berred16/BT9803-Modul/IMG_0519.JPG

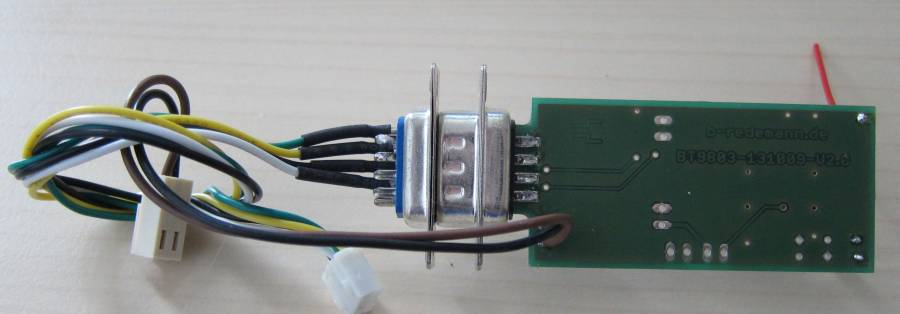
IMG_0519.JPG
