berred16/BT9803-Modul/IMG_0517.JPG

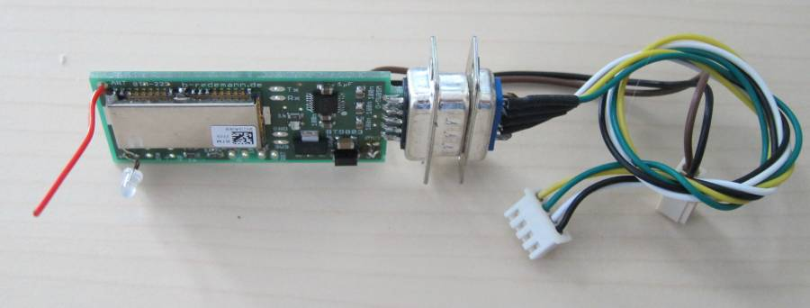
IMG_0517.JPG
