berred16/BT9803-Modul/BT9803-Bestückung.png

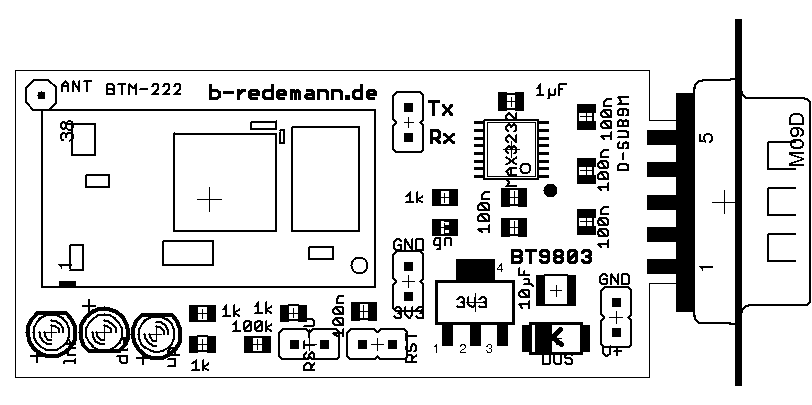
BT9803-Bestückung.png
