berred16/BT9803-Modul/BT9803-Stromlauf.png

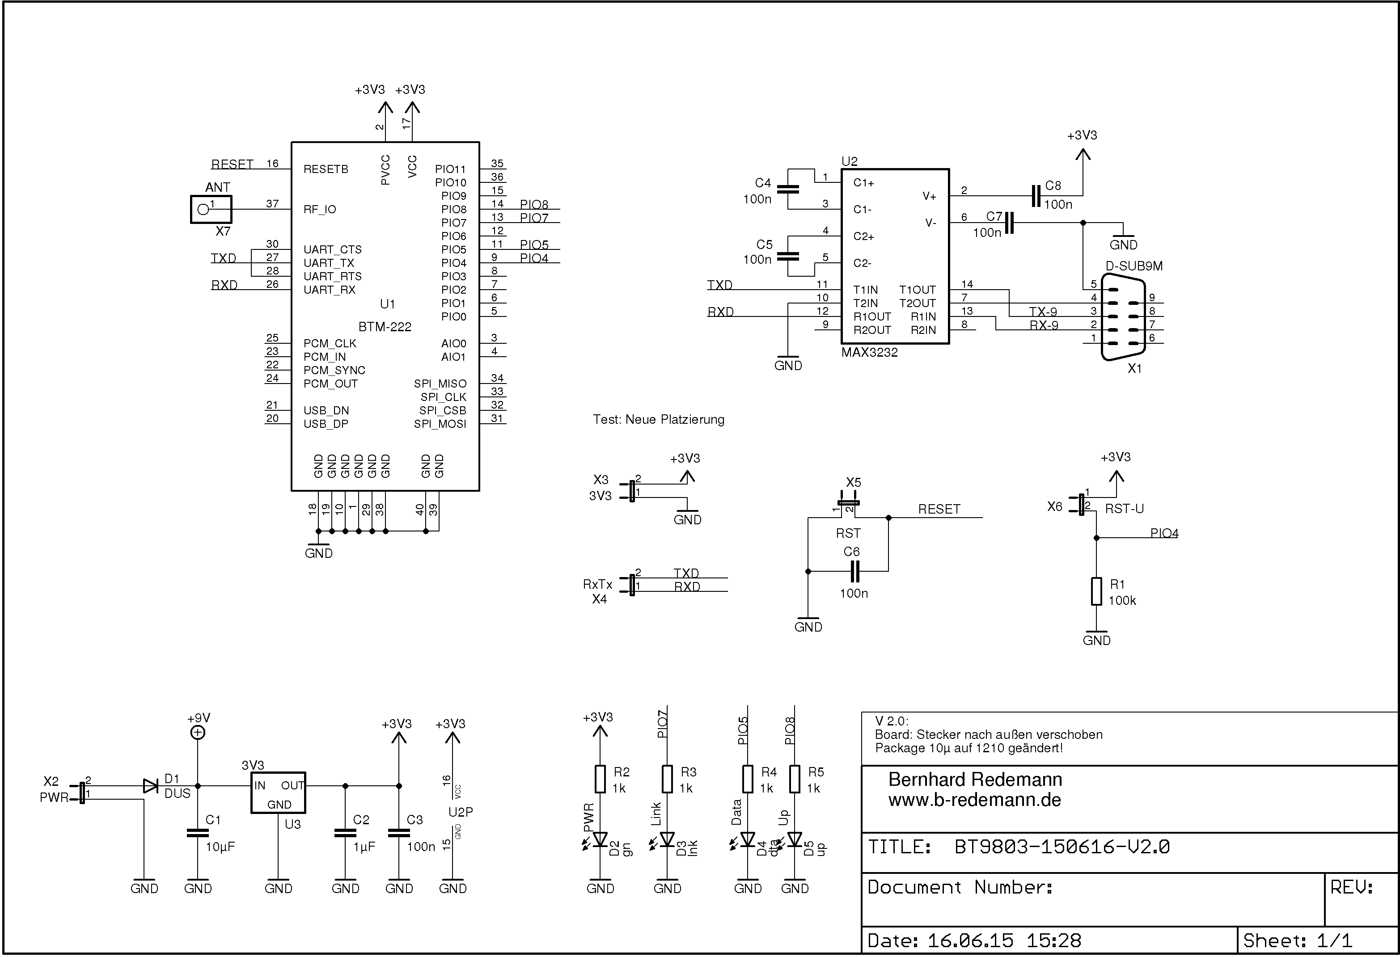
BT9803-Stromlauf.png
