berred16/BT9803-Modul/IMG_0501.JPG

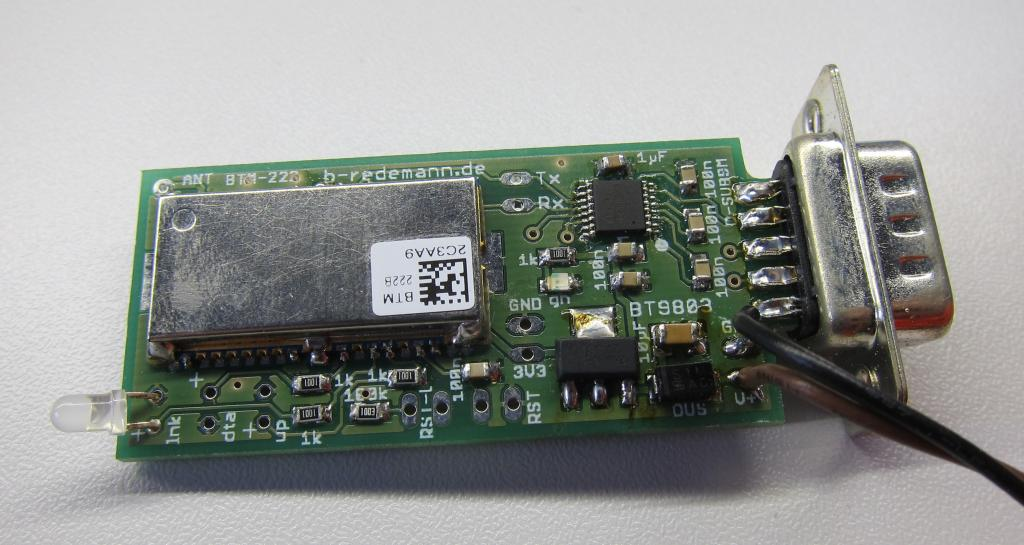
IMG_0501.JPG
