berred16/BT9803-Modul/IMG_0518.JPG

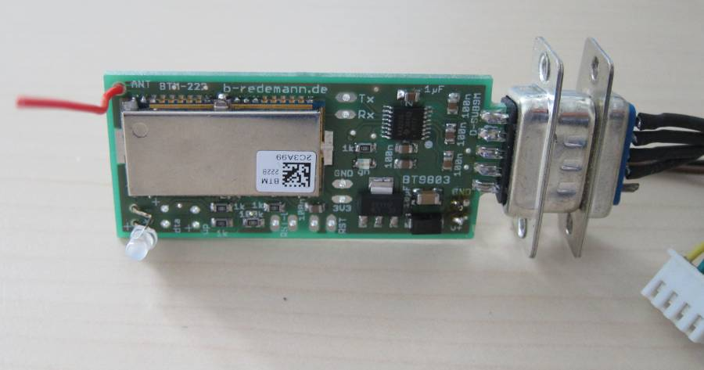
IMG_0518.JPG
