berred16/BT9803-Modul/IMG_0523.JPG

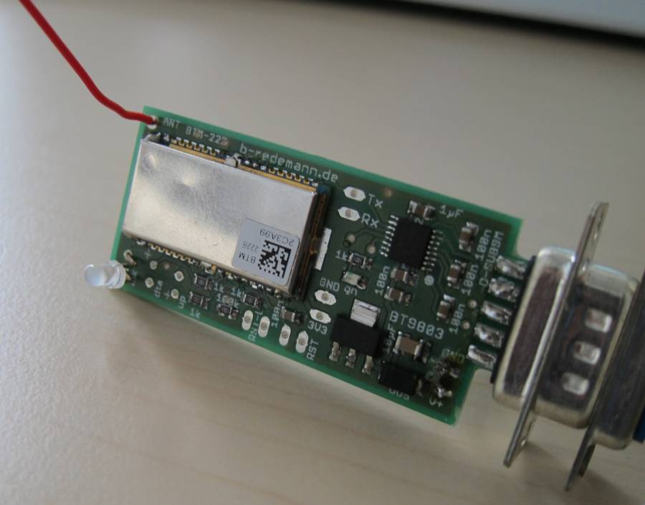
IMG_0523.JPG
