berred16/BT9803-Modul/BT9803-150616-V2.0.brd

## EAGLE design BT9803-150616-V2.0.brd (2016-10-22)

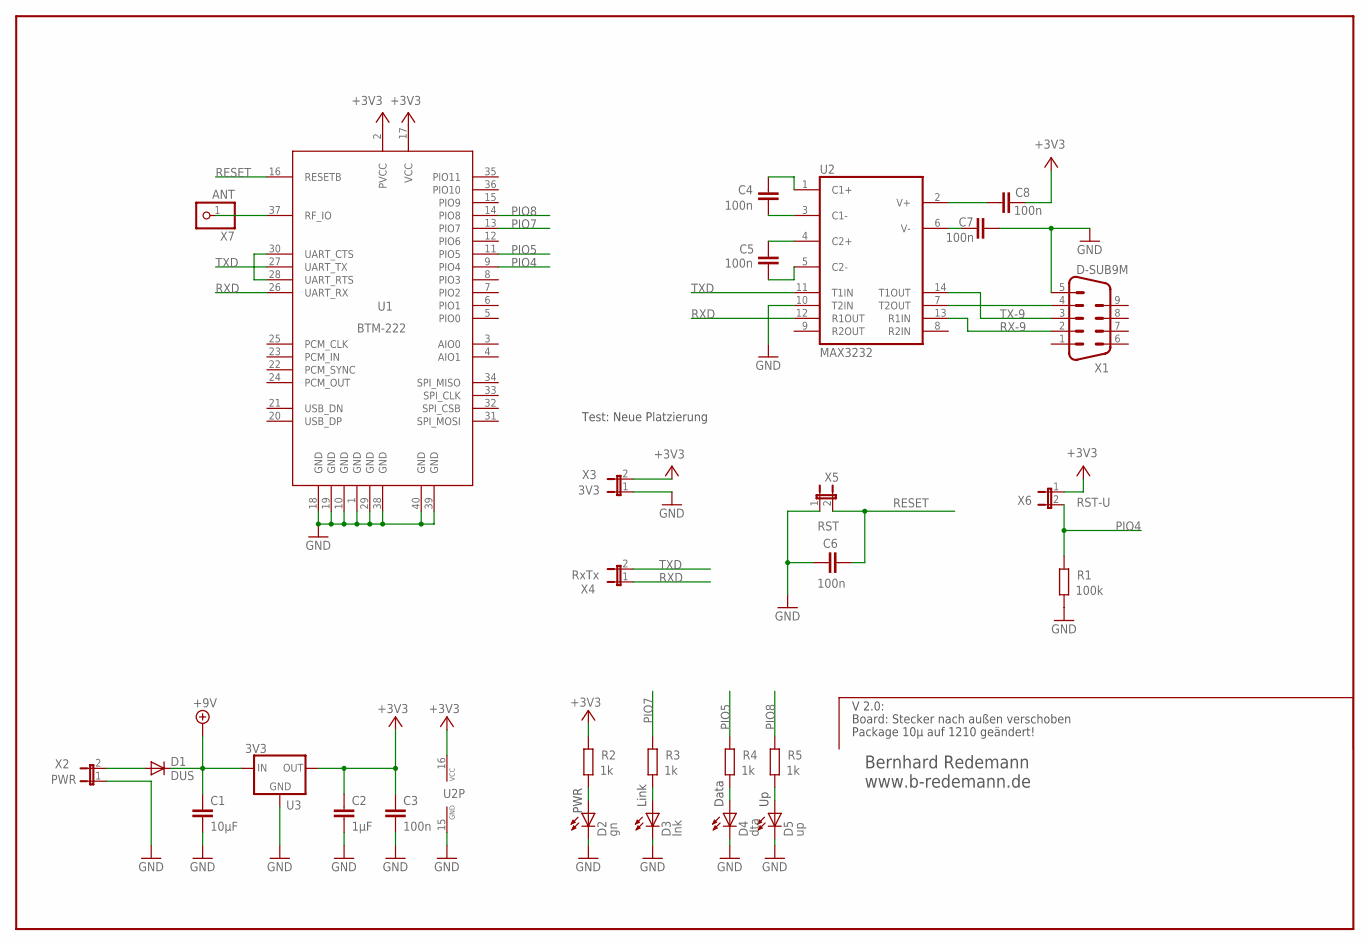
[picture p15: schematic BT9803-150616-V2.0.sch]

Parts:
C1: 10µF; C1210
C2: 1µF; C0805
C3, C4, C5, C6, C7, C8: 100n; C0805
D1: DUS; DO-214AC
D2: gn; CHIP-LED0805
D3: lnk; LED3MM
D4: dta; LED3MM
D5: up; LED3MM
R1: 100k; R0805
R2, R3, R4, R5: 1k; R0805
U1: BTM-222; 38-PIN15
U2: MAX3232; TSSOP16
U3: 3V3; SOT223
X1: D-SUB9M; M09D
X2: PWR; JP1
X3: 3V3; JP1
X4: RxTx; JP1
X5: RST; JP1
X6: RST-U; JP1
X7: ANT; 1X01

Connections:
+3V3: C2.1, C3.1, C8.1, R2.1, U1.2 (PVCC), U1.17 (VCC), U2.16 (VCC), U3.2 (OUT), X3.2, X6.1
+9V: C1.1, D1.C, U3.3 (IN)
DATA: D4.A, R4.2
GND: C1.2, C2.2, C3.2, C6.1, C7.1, D2.C, D3.K (C), D4.K (C), D5.K (C), R1.2, U1.1 (GND), U1.10 (GND), U1.18 (GND), U1.19 (GND), U1.29 (GND), U1.38 (GND), U1.39 (GND), U1.40 (GND), U2.10 (T2IN), U2.15 (GND), U3.1 (GND), X1.5, X2.1, X3.1, X5.1
LINK: D3.A, R3.2
unnamed: U2.7 (T2OUT), X1.4
unnamed: U1.28 (UART_RTS), U1.30 (UART_CTS)
unnamed: D1.A, X2.2
unnamed: C4.1, U2.3 (C1-)
unnamed: C5.2, U2.4 (C2+)
unnamed: C4.2, U2.1 (C1+)
unnamed: C5.1, U2.5 (C2-)
unnamed: C7.2, U2.6 (V-)
unnamed: C8.2, U2.2 (V+)
PIO4: R1.1, U1.9 (PIO4), X6.2
PIO5: R4.1, U1.11 (PIO5)
PIO7: R3.1, U1.13 (PIO7)
PIO8: R5.1, U1.14 (PIO8)
PWR: D2.A, R2.2
RESET: C6.2, U1.16 (RESETB), X5.2
RF-222: U1.37 (RF_IO), X7.1
RX-9: U2.13 (R1IN), X1.2
RXD: U1.26 (UART_RX), U2.12 (R1OUT), X4.1
TX-9: U2.14 (T1OUT), X1.3
TXD: U1.27 (UART_TX), U2.11 (T1IN), X4.2
UP: D5.A, R5.2

Notes on the sheet:
Bernhard Redemann www.b-redemann.de
Link
PWR
Data
Package 10µ auf 1210 geändert!
Board: Stecker nach außen verschoben
V 2.0:
Test: Neue Platzierung

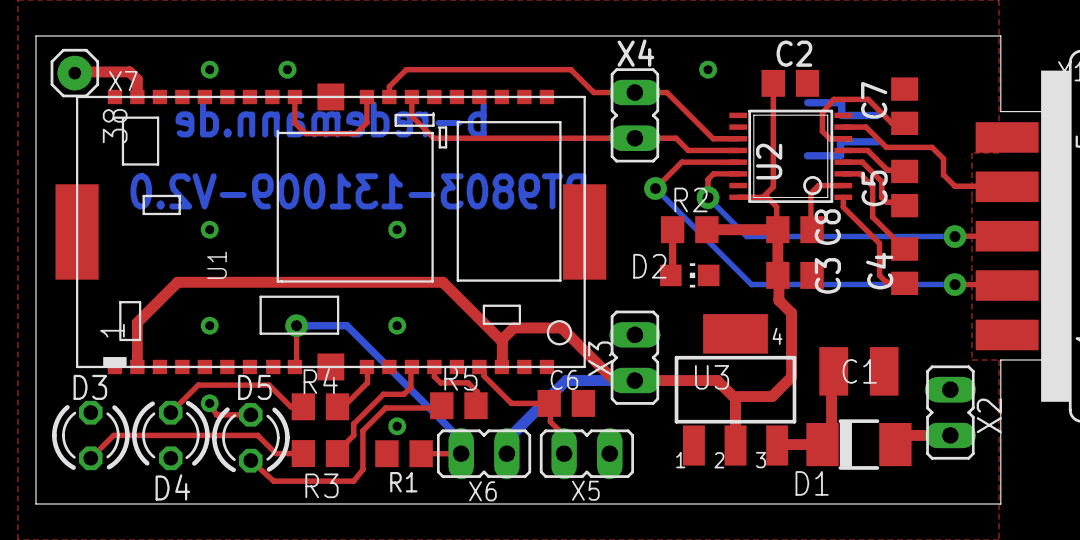
[picture p16: board BT9803-150616-V2.0.brd from above]

Board: 2 copper layers, 56.0 x 26.0 mm, 28 parts (0 on the bottom side), 26 nets.
